h-xh-git/DualCore-Oscilloscope/(notices)

Notices in the files:
README.md:
License: GPL v3
